zxzteh/temp_to_pwm_converter/Project/Core/Src/main.c

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
/* Includes ------------------------------------------------------------------*/
#include "main.h"

CRC_HandleTypeDef hcrc;

IWDG_HandleTypeDef hiwdg;

TIM_HandleTypeDef htim1;
TIM_HandleTypeDef htim14;

UART_HandleTypeDef huart1;
UART_HandleTypeDef huart2;

void SystemClock_Config(void);
static void MX_GPIO_Init(void);
static void MX_TIM14_Init(void);
static void MX_USART1_UART_Init(void);
static void MX_USART2_UART_Init(void);
static void MX_IWDG_Init(void);
static void MX_CRC_Init(void);
static void MX_TIM1_Init(void);
/* USER CODE BEGIN PFP */
static void touch_grass();
/* USER CODE END PFP */

/**
  * @brief  The application entry point.
  * @retval int
  */
int main(void)
{

  /* MCU Configuration--------------------------------------------------------*/

  /* Reset of all peripherals, Initializes the Flash interface and the Systick. */
  HAL_Init();

  /* Configure the system clock */
  SystemClock_Config();

  /* Initialize all configured peripherals */
  MX_GPIO_Init();
  MX_TIM14_Init();
  MX_USART1_UART_Init();
  MX_USART2_UART_Init();
  MX_IWDG_Init();
  MX_CRC_Init();
  MX_TIM1_Init();
  /* USER CODE BEGIN 2 */


  while (ds18b20_init(&UART_ONE_WIRE)) {
	  debug_print(ERR, "Trying to reinit . . .");
	  HAL_Delay(100);  //  watchdog will do
  }


  HAL_TIM_PWM_Start(&TIM_PWM, TIM_CHANNEL_1);
  HAL_TIM_OC_Start_IT(&TIM_MEASURE, TIM_CHANNEL_2);
  HAL_TIM_OC_Start_IT(&TIM_MEASURE, TIM_CHANNEL_1);
  /* USER CODE END 2 */

  /* Infinite loop */
  /* USER CODE BEGIN WHILE */
  while (1)
  {
    touch_grass();
    /* USER CODE END WHILE */

    /* USER CODE BEGIN 3 */

  }
  /* USER CODE END 3 */
}

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
/* USER CODE BEGIN 4 */
static void touch_grass() {
  static uint64_t grass_touched_counter = 0;
  grass_touched_counter++;
  HAL_IWDG_Refresh(&hiwdg);
}

void float_to_str(float value, char *buffer, uint8_t precision) {
    uint8_t is_negative = (value < 0);
    if (is_negative) {
        value = -value;
    }
    int int_part = (int)value;
    float frac_part = value - int_part;
    sprintf(buffer, "%s%d.", is_negative ? "-" : "", int_part);
    for (uint8_t i = 0; i < precision; i++) {
        frac_part *= 10;
        buffer[strlen(buffer)] = '0' + (int)frac_part;
        frac_part -= (int)frac_part;
    }
    buffer[strlen(buffer)] = '\0';
}

/* USER CODE END 4 */
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
