zxzteh/temp_to_pwm_converter/Project/temp_to_pwm_conv.ioc

Mcu.UserName=STM32G031F6Px
PA13.Signal=SYS_SWDIO
PA14-BOOT0.Signal=SYS_SWCLK
PA2.Signal=USART2_TX
PA3.Signal=USART2_RX
PA4.Signal=S_TIM14_CH1
PA5.GPIO_Label=DEBUG_PIN
PA5.Signal=GPIO_Output
PB6.Signal=USART1_TX
