zxzteh/temp_to_pwm_converter/(commit log)

2025-03-14 One wire implementation on progress
2025-03-15 one wire working, ds18b20 in progress
2025-03-15 temp sensor working
2025-03-15 schematic added
