zxzteh/temp_to_pwm_converter/(notices)

Notices in the files:
Project/Core/Src/main.c:
Copyright (c) 2025 STMicroelectronics.
All rights reserved.
This software is licensed under terms that can be found in the LICENSE file
